rvolgers/Glasgow/hardware/boards/glasgow/Cypress.sch

## KiCad design hardware/boards/glasgow/Cypress.sch (2018-07-29)

Schematic: Cypress.sch

Parts:
C1: 4u7; C_0603_1608Metric_Pad0.99x1.00mm_HandSolder; MPN LMK107BJ475KAHT
C2, C3, C4, C5, C6, C7, C9, C10: u1; C_0603_1608Metric_Pad0.99x1.00mm_HandSolder; MPN TMK107BJ154KA-T
C11, C12: 18p; C_0603_1608Metric_Pad0.99x1.00mm_HandSolder; MPN CC0603JRNPO8BN180
R4, R9, R11, R17, R18, R19: 100k; R_0603_1608Metric_Pad0.99x1.00mm_HandSolder; MPN RC0603FR-10100KL
TP6: CLKREF; TestPoint_Pad_D1.0mm
TP7: 3V3; TestPoint_Pad_D1.0mm
U1: CY7C68013A-56LTX; Cypress_QFN-56-1EP_8x8mm_P0.5mm_EP6.22x6.22mm_ThermalVias; MPN CY7C68013A-56LTXC
Y1: 24M; Crystal_SMD_3225-4pin_3.2x2.5mm; MPN LFXTAL058124REEL

Notes on the sheet:
Imax(USB) @ 3V3 = 80 mA Imax @ 3V3 = 209 mA
Alternate use for FLAGD pin: INT1
FPGA reset asserted on tristate
