rvolgers/Glasgow/hardware/boards/glasgow/glasgow.sch

## KiCad design hardware/boards/glasgow/glasgow.sch (2018-07-29)

Schematic: glasgow.sch

Parts:
C8, C13, C15, C17, C20, C21, C22, C23, C24, C25, C33: u1; C_0603_1608Metric_Pad0.99x1.00mm_HandSolder; MPN TMK107BJ154KA-T
C14, C16, C18, C19, C26, C27, C28: 4u7; C_0603_1608Metric_Pad0.99x1.00mm_HandSolder; MPN LMK107BJ475KAHT
D1, D2, D3: GRN; LED_0603_1608Metric_Pad0.82x1.00mm_HandSolder; MPN 150060GS75000
D4: YEL; LED_0603_1608Metric_Pad0.82x1.00mm_HandSolder; MPN 150060YS75000
D5: RED; LED_0603_1608Metric_Pad0.82x1.00mm_HandSolder; MPN 150060RS75000
J1: USB_B_Micro; USB_Micro-B_Molex_47346-0001; MPN 47346-0001
J4: Conn_01x02; PinHeader_1x02_P2.54mm_Horizontal; MPN 22-05-3021
MK1, MK2, MK3, MK4: Mounting_Hole_PAD; MountingHole_3.2mm_M3_Pad
MK5, MK6: Mounting_Hole; MountingHole_2.5mm
R1, R2, R12, R13, R14: 2k2; R_0603_1608Metric_Pad0.99x1.00mm_HandSolder; MPN RC0603FR-132K2L
R3: 1M; R_0603_1608Metric_Pad0.99x1.00mm_HandSolder; MPN RC0603FR-131ML
R5: 220k; R_0603_1608Metric_Pad0.99x1.00mm_HandSolder; MPN RC0603FR-10220KL
R6, R7, R8: 100k; R_0603_1608Metric_Pad0.99x1.00mm_HandSolder; MPN RC0603FR-10100KL
R10, R15: 390; R_0603_1608Metric_Pad0.99x1.00mm_HandSolder; MPN RC0603FR-13390RL
R16: 604; R_0603_1608Metric_Pad0.99x1.00mm_HandSolder; MPN RC0603FR-07604RL
R30: 100; R_0603_1608Metric_Pad0.99x1.00mm_HandSolder; MPN RC0603FR-07100RL
TP1: 5V; TestPoint_Pad_D1.0mm
TP2: 1V2; TestPoint_Pad_D1.0mm
TP3: 3V3; TestPoint_Pad_D1.0mm
TP4: SDA; TestPoint_Pad_D1.0mm
TP5: SCL; TestPoint_Pad_D1.0mm
U2: CAT24M01W; SOIC-8_3.9x4.9mm_P1.27mm; MPN CAT24M01WI-GT3
U3: CAT24C256W; SOIC-8_3.9x4.9mm_P1.27mm; MPN CAT24C256WI-GT3
U4: ICE40UP5K-SG48ITR; QFN-48-1EP_7x7mm_P0.5mm_EP5.15x5.15mm; MPN ICE40UP5K-SG48ITR50
U7: LM3880MF-1AF; SOT-23-6; MPN LM3880MFX-1AF/NOPB
U8: MIC5355-S4YMME; MSOP-8-1EP_3x3mm_P0.65mm_EP2.54x2.8mm_ThermalVias; MPN MIC5355-S4YMME
U15: TPD3S014; SOT-23-6; MPN TPD3S014DBVR

Notes on the sheet:
All at 30 mcd
0.3 mA
5 mA
3 mA
Stencil alignment
Turn on at VBUS >4.5V
Addr: 101001X
Addr: 1010001
500 mA @ 1V2 500 mA @ 3V3
Addr DAC: 0001100 Addr ADC: 1010100
Addr DAC: 0001101 Addr ADC: 1010101
Imax @ 3V3 = 312 mA (all banks)
Imax @ 3V3 = 5 mA
Imax @ 3V3 = 3 mA
Imax @ 3V3 = 38 mA (A+B) Imax @ 5V = 150 mA (A+B)
Addr: 0001000
FX2_MEM
ICE_MEM
