rvolgers/Glasgow/hardware/boards/glasgow/io_buffer.sch

## KiCad design hardware/boards/glasgow/io_buffer.sch (2018-07-22)

Schematic: io_buffer.sch

Parts:
C29, C34, C39: 4u7; C_0603_1608Metric_Pad0.99x1.00mm_HandSolder; MPN LMK107BJ475KAHT
C30, C32, C35, C36, C38, C40, C47, C48, C49, C50, C51, C52, C53, C54, C55, C56, C57, C58, C59: u1; C_0603_1608Metric_Pad0.99x1.00mm_HandSolder; MPN TMK107BJ154KA-T
C37: 12n; C_0603_1608Metric_Pad0.99x1.00mm_HandSolder; MPN CC0603KRX7R8BB123
J2: Conn_02x10_Odd_Even; PinHeader_2x10_P2.54mm_Vertical; MPN 87834-2019
R20, R21: 10k; R_0603_1608Metric_Pad0.99x1.00mm_HandSolder; MPN RC0603FR-1010KL
R22: 49k9; R_0603_1608Metric_Pad0.99x1.00mm_HandSolder; MPN RC0603FR-0749K9L
R23: 59k; R_0603_1608Metric_Pad0.99x1.00mm_HandSolder; MPN RC0603FR-0759KL
R24: 24k3; R_0603_1608Metric_Pad0.99x1.00mm_HandSolder; MPN AC0603FR-0724K3L
RN1, RN2: R_Pack08; R_Array_Convex_8x0602; MPN TBD
U5, U6, U16, U17, U18, U19, U20, U21: SN74LVC1T45DRL; SOT-563
U9: ADC081C021CIMM; MSOP-8_3x3mm_P0.65mm; MPN ADC081C021CIMM/NOPB
U10: DAC081C081CIMK; SOT-23-6; MPN DAC081C081CIMK/NOPB
U11: TPS73101DBV; SOT-23-5; MPN TPS73101DBVR

Notes on the sheet:
Addr (ADR=X): 0001100 Addr (ADR=L): 0001101 Addr (ADR=H): 0001110
Addr (ADR=X): 1010100 Addr (ADR=L): 1010101 Addr (ADR=H): 1010110
Csamp = 20 pF Bits = 8 Cext = (2**(Bits+1)-1)*Csamp = 10.2 nF (min) Gamma = ln(2**(Bits+1)) = 6.24 Freq = 1 ksps Rsource = 1/(Gamma*Cext*Freq) = 15.7 kohm (max) Rdiv = 2*Rsource = 31.4 kohm (max)
Imax @ 3V3 = 0.16 mA
Imax @ 3V3 = 0.73 mA
Imax @ 5V = 150 mA
Imax @ 3V3 = 32 mA each Imax @ Vtg = 32 mA each
LDO Input Cap
