rvolgers/Glasgow/(commit log)

2018-07-22 Initial Rev C IO cell schematic.
    [io_buffer.sch]
2018-07-29 Refactor FX2 into hierarchical subsheet.
    [Cypress.sch, glasgow.sch]
